pongsagon/tt07-tiniest-gpu/test_software/pic.jpg

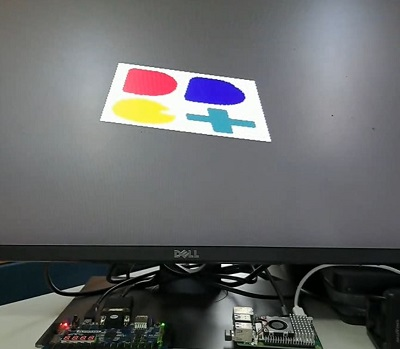
test_software/pic.jpg
