pongsagon/tt07-tiniest-gpu/verilator_sim/ddct.jpg

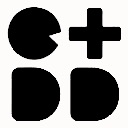
verilator_sim/ddct.jpg
