pongsagon/tt07-tiniest-gpu/verilator_sim/sk.jpg

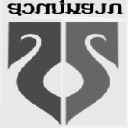
verilator_sim/sk.jpg
