pongsagon/tt07-tiniest-gpu/verilator_sim/tt.jpg

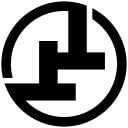
verilator_sim/tt.jpg
