pongsagon/tt07-tiniest-gpu/src/bitmap_rom_ddct.v

//`timescale 1ns / 1ps
module bitmap_rom_ddct (
    input wire [6:0] x,
    input wire [6:0] y,
    output wire pixel
);

  reg [7:0] mem[2047:0];
  initial begin
    mem[0] = 8'h00;
    mem[1] = 8'h00;
    mem[2] = 8'h00;
    mem[3] = 8'h00;
    mem[4] = 8'h00;
    mem[5] = 8'h00;
    mem[6] = 8'h00;
    mem[7] = 8'h00;
    mem[8] = 8'h00;
    mem[9] = 8'h00;
    mem[10] = 8'h00;
    mem[11] = 8'h00;
    mem[12] = 8'h00;
    mem[13] = 8'h00;
    mem[14] = 8'h00;
    mem[15] = 8'h00;
    mem[16] = 8'h00;
    mem[17] = 8'h00;
    mem[18] = 8'h00;
    mem[19] = 8'h00;
    mem[20] = 8'h00;
    mem[21] = 8'h00;
    mem[22] = 8'h00;
    mem[23] = 8'h00;
    mem[24] = 8'h00;
    mem[25] = 8'h00;
    mem[26] = 8'h00;
    mem[27] = 8'h00;
    mem[28] = 8'h00;
    mem[29] = 8'h00;
    mem[30] = 8'h00;
    mem[31] = 8'h00;
    mem[32] = 8'h00;
    mem[33] = 8'h00;
    mem[34] = 8'h00;
    mem[35] = 8'h00;
    mem[36] = 8'h00;
    mem[37] = 8'h00;
    mem[38] = 8'h00;
    mem[39] = 8'h00;
    mem[40] = 8'h00;
    mem[41] = 8'h00;
    mem[42] = 8'h00;
    mem[43] = 8'h00;
    mem[44] = 8'h00;
    mem[45] = 8'h00;
    mem[46] = 8'h00;
    mem[47] = 8'h00;
    mem[48] = 8'h00;
    mem[49] = 8'h00;
    mem[50] = 8'h00;
    mem[51] = 8'h00;
    mem[52] = 8'h00;
    mem[53] = 8'h00;
    mem[54] = 8'h00;
    mem[55] = 8'h00;
    mem[56] = 8'h00;
    mem[57] = 8'h00;
    mem[58] = 8'h00;
    mem[59] = 8'h00;
    mem[60] = 8'h00;
    mem[61] = 8'h00;
    mem[62] = 8'h00;
    mem[63] = 8'h00;
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
    mem[2039] = 8'h00;
    mem[2040] = 8'h00;
    mem[2041] = 8'h00;
    mem[2042] = 8'h00;
    mem[2043] = 8'h00;
    mem[2044] = 8'h00;
    mem[2045] = 8'h00;
    mem[2046] = 8'h00;
    mem[2047] = 8'h00;
  end

  wire [10:0] addr = {y[6:0], x[6:3]};
  assign pixel = mem[addr][x&7];

endmodule
