pongsagon/tt07-tiniest-gpu/src/ia.v

//`timescale 1ns / 1ps
//`default_nettype wire



module ia(
	input clk, 		
	input reset,
	input rx,
	output reg pc_ready,				//must be true for only 1 clk
	output reg [7:0] read_data,
	output reg [6:0] idx,				// 0-60
	output reg update_reg
	);
	
	
	wire read_done;
	wire [7:0] byte_data;

	uart_top UART_UNIT(.clk(clk),.reset(reset),.rx(rx),
						.rx_data_out(byte_data),.rx_done_tick(read_done));


	reg [1:0] state;

	always @(posedge clk) begin
		if (reset) begin
			pc_ready <= 0;
			update_reg <= 0;
			idx <= 0;
			read_data <= 0;
			state <= 0;
		end
		else begin
			case (state)
				0: begin
					pc_ready <= 0;
					update_reg <= 0;
					if (read_done) begin
						read_data <= byte_data;
						idx <= 0;
						update_reg <= 1;
						state <= 1;
					end
				end
				1: begin
					update_reg <= 0;
					if (idx < 59) begin
						if (read_done) begin
							read_data <= byte_data;
							idx <= idx + 1;
							update_reg <= 1;
							state <= 1;
						end
					end
					else begin
						pc_ready <= 1;
						state <= 0;
					end
				end
				

				default: begin
					state <= 0;
				end
			endcase
		end
	end
	
endmodule
