pongsagon/tt07-tiniest-gpu/(commit log)

2025-10-05 Fix Barycentric coordinate formula
    the previous version contain incorrect formula.
    [vs.v]
2025-10-05 Fix barycentric formula
    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
    [vs.v]
