pongsagon/tt07-tiniest-gpu/(notices)

Notices in the files:
verilator_sim/slowmpy.v:
Copyright (C) 2018-2024, Gisselquist Technology, LLC
modify it under the terms of the GNU General Public License as published
License: GPL, v3, as defined and found on www.gnu.org,
http://www.gnu.org/licenses/gpl.html
